al-chris/esp32_smart_room_controller/secrets.example.h

#ifndef SECRETS_H
#define SECRETS_H

// Copy this file to secrets.h and fill in your own values.
// secrets.h is git-ignored; this template is safe to share.

// ================= WiFi =================
#define WIFI_SSID     "your-wifi-name"
#define WIFI_PASSWORD "your-wifi-password"

// ================= Firebase =================
#define WEB_API_KEY   "your-firebase-web-api-key"
#define DATABASE_URL  "https://your-project-default-rtdb.firebaseio.com"
#define USER_EMAIL    "device@example.com"
#define USER_PASS     "your-firebase-user-password"

#endif // SECRETS_H
