al-chris/esp32_smart_room_controller/(commit log)

2026-09-25 initila commit: Add wiring diagrams and configuration template for home automation project
    - Added home_automation_wiring_ld2410.png for wiring reference.
    - Introduced secrets.example.h for user-specific configuration (WiFi, Firebase).
    - Created wiring_RD-03D.svg detailing connections for RD-03D radar, ESP32, DHT22, and relay module.
    - Added wiring_ld2410.svg for LD2410 radar setup, including notes on power requirements and pin connections.
2026-09-25 chore(docs): Remove outdated wiring diagram reference and clarify voltage requirements for RD-03D radar
